DanVrazel/simple-nanoamperemeter/PCB/PCB.kicad_pcb

## KiCad design PCB/PCB.kicad_pcb (2025-10-04)

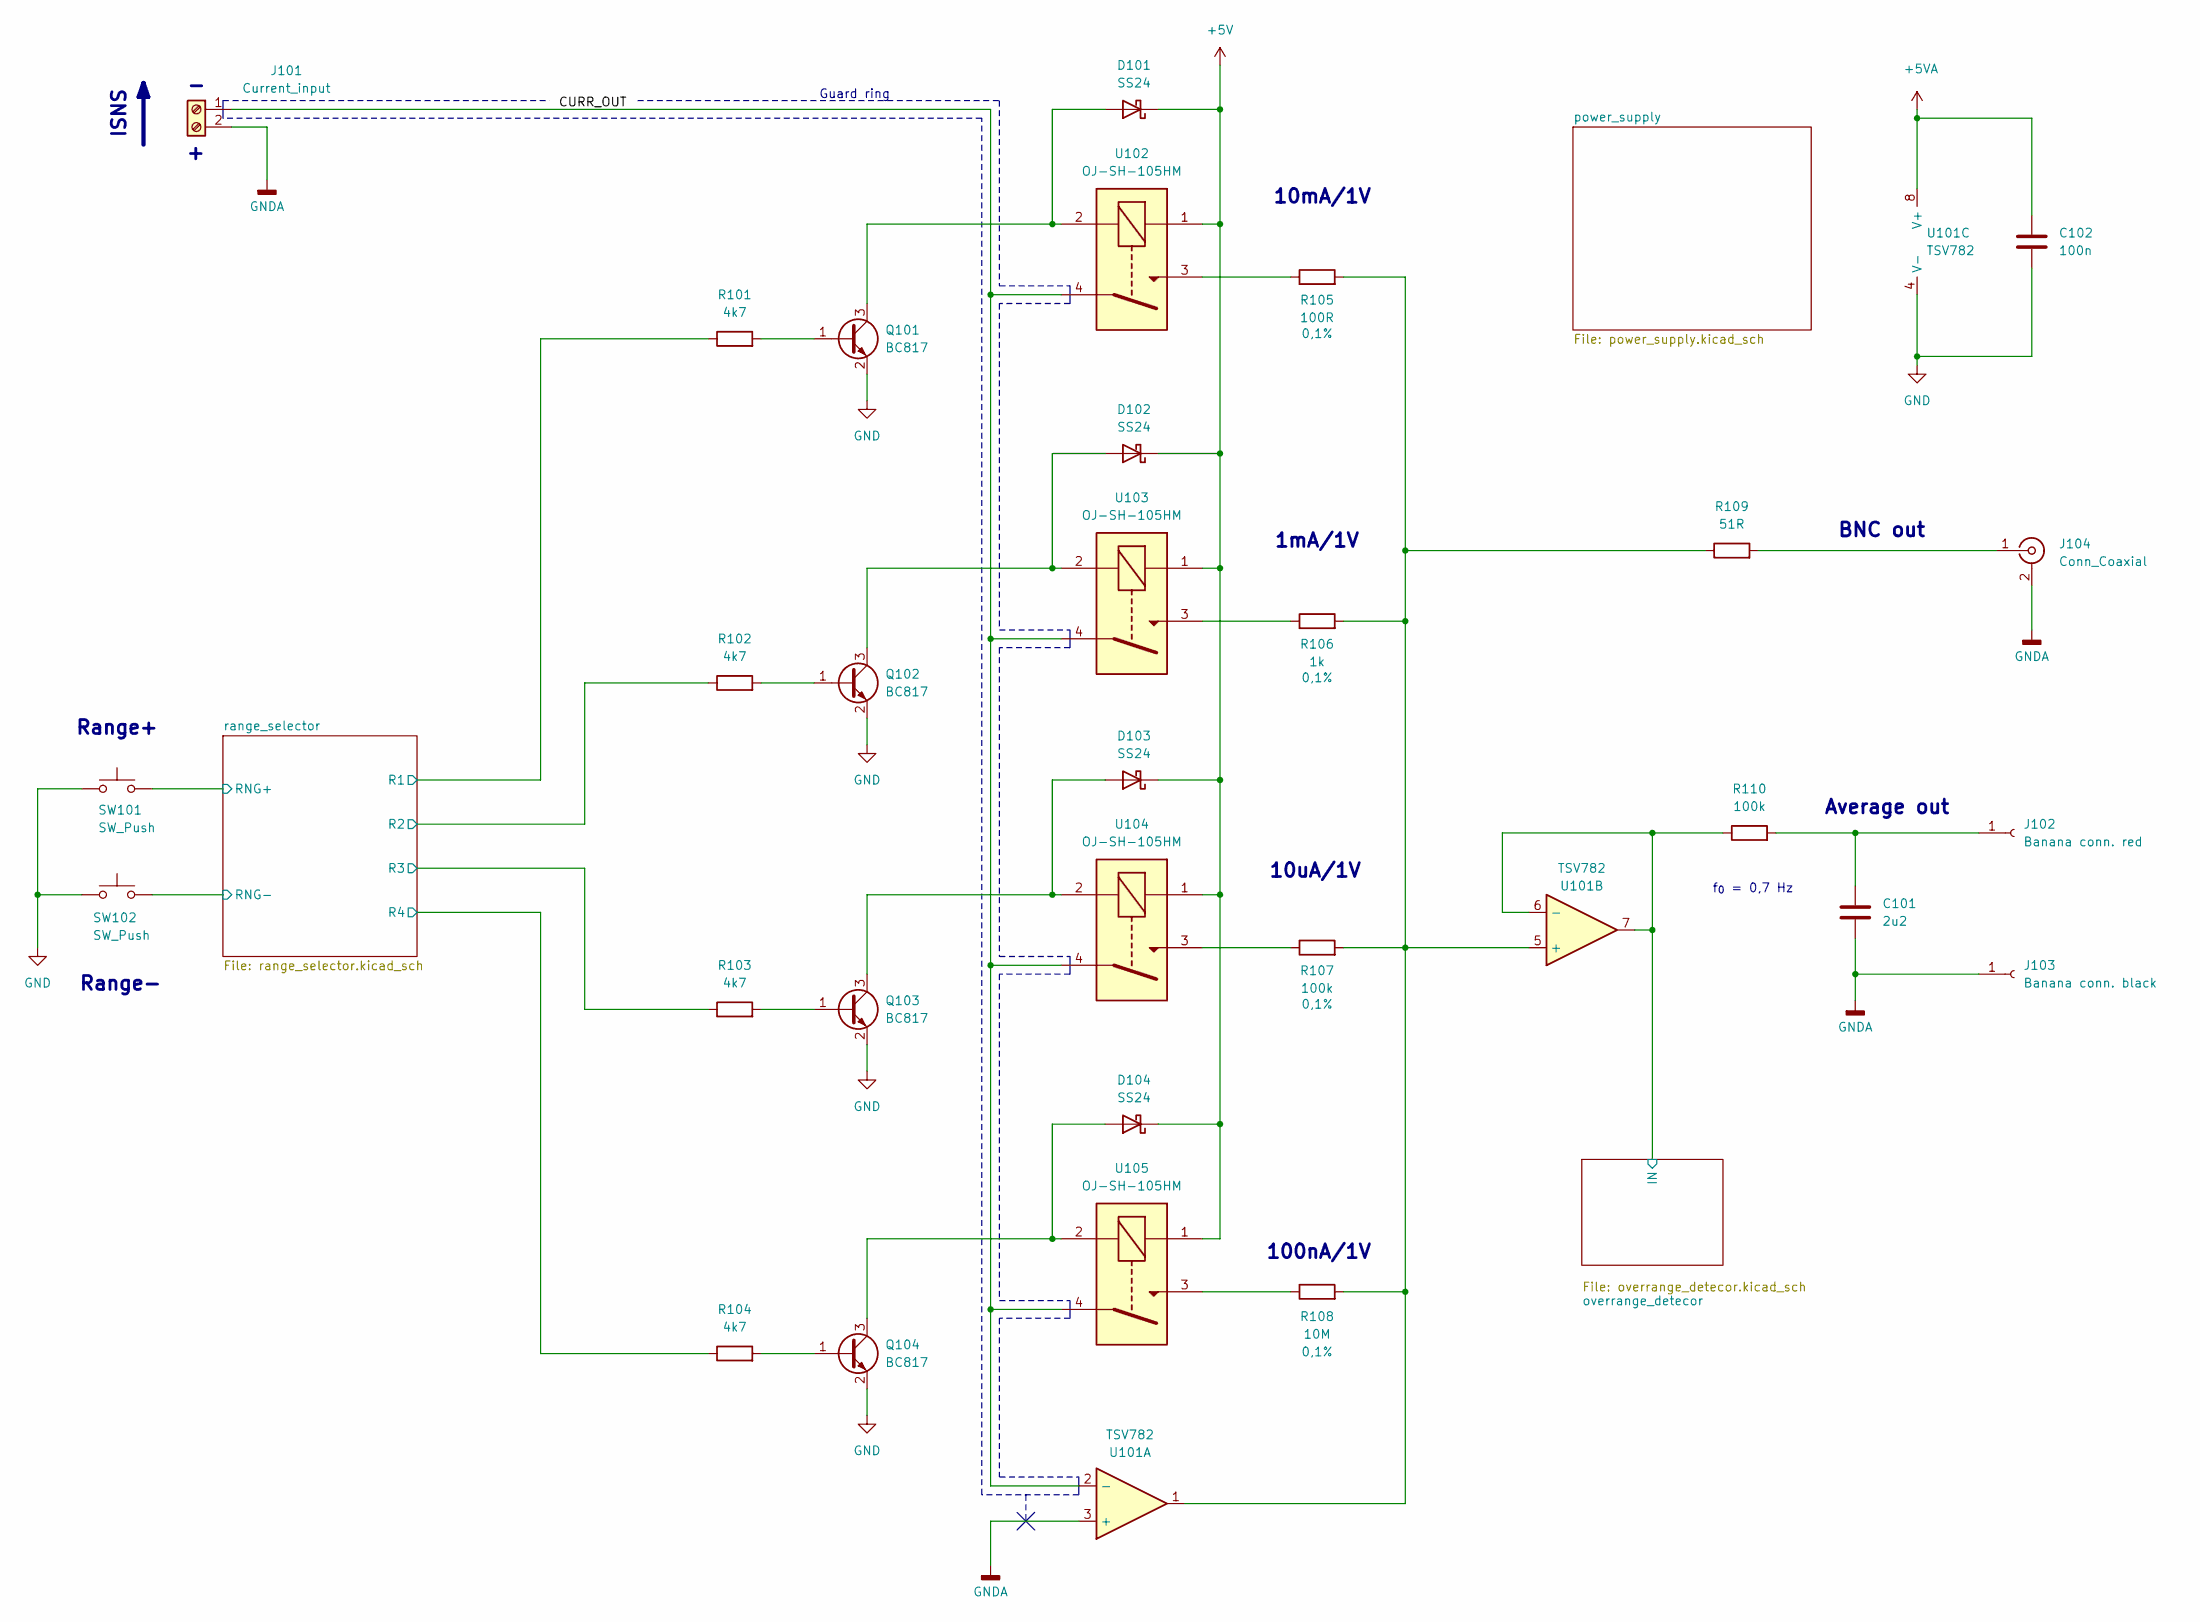
[picture p1: schematic PCB.kicad_sch]

Parts:
C101: 2u2; C_0603_1608Metric
C102: 100n; C_0603_1608Metric
D101, D102, D103, D104: SS24; SOD-123LF
J101: Current_input; Terminal Block 2x3,5mm
J102: Banana conn. red; J.40024.2
J103: Banana conn. black; J.40024.2
J104: Conn_Coaxial; BNC_Amphenol_B6252HB-NPP3G-50_Horizontal
Q101, Q102, Q103, Q104: BC817; SOT-23
R101, R102, R103, R104: 4k7; R_0603_1608Metric
R105: 100R; R_0603_1608Metric
R106: 1k; R_0603_1608Metric
R107, R110: 100k; R_0603_1608Metric
R108: 10M; R_1206_3216Metric; Mouser MCA1206MD1005BP500
R109: 51R; R_0603_1608Metric
SW101, SW102: SW_Push; SW_Tactile_SPST_Angled_PTS645Vx83-2LFS
U101: TSV782; SOIC-8
U102, U103, U104, U105: OJ-SH-105HM; TE Connectivity Relay

Connections:
+5V: D101.1 (K), D102.1 (K), D103.1 (K), D104.1 (K), U102.1, U103.1, U104.1, U105.1; also elsewhere on the board
/CURR_OUT: J101.1, U101.2 (-), U102.4, U103.4, U104.4, U105.4
/overrange_detecor/IN: R110.1, U101.6 (-), U101.7; also elsewhere on the board
/range_selector/R1: R101.1; also elsewhere on the board
/range_selector/R2: R102.1; also elsewhere on the board
/range_selector/R3: R103.1; also elsewhere on the board
/range_selector/R4: R104.1; also elsewhere on the board
/range_selector/RNG+: SW101.2; also elsewhere on the board
/range_selector/RNG-: SW102.2; also elsewhere on the board
GNDA: C101.2, J101.2, J103.1, J104.2 (Ext), U101.3 (+); also elsewhere on the board
unnamed: D101.2 (A), Q101.3 (C), U102.2
unnamed: D102.2 (A), Q102.3 (C), U103.2
unnamed: D103.2 (A), Q103.3 (C), U104.2
unnamed: D104.2 (A), Q104.3 (C), U105.2
unnamed: C101.1, J102.1, R110.2
unnamed: J104.1 (In), R109.2
unnamed: Q101.1 (B), R101.2
unnamed: Q102.1 (B), R102.2
unnamed: Q103.1 (B), R103.2
unnamed: Q104.1 (B), R104.2
unnamed: R105.1, U102.3
unnamed: R106.1, U103.3
unnamed: R107.1, U104.3
unnamed: R108.1, U105.3
unnamed: R105.2, R106.2, R107.2, R108.2, R109.1, U101.1, U101.5 (+)

Notes on the sheet:
10mA/1V
ISNS
Range+
Guard ring
10uA/1V
Average out
100nA/1V
1mA/1V
f_{0} = 0,7 Hz
Range-
BNC out

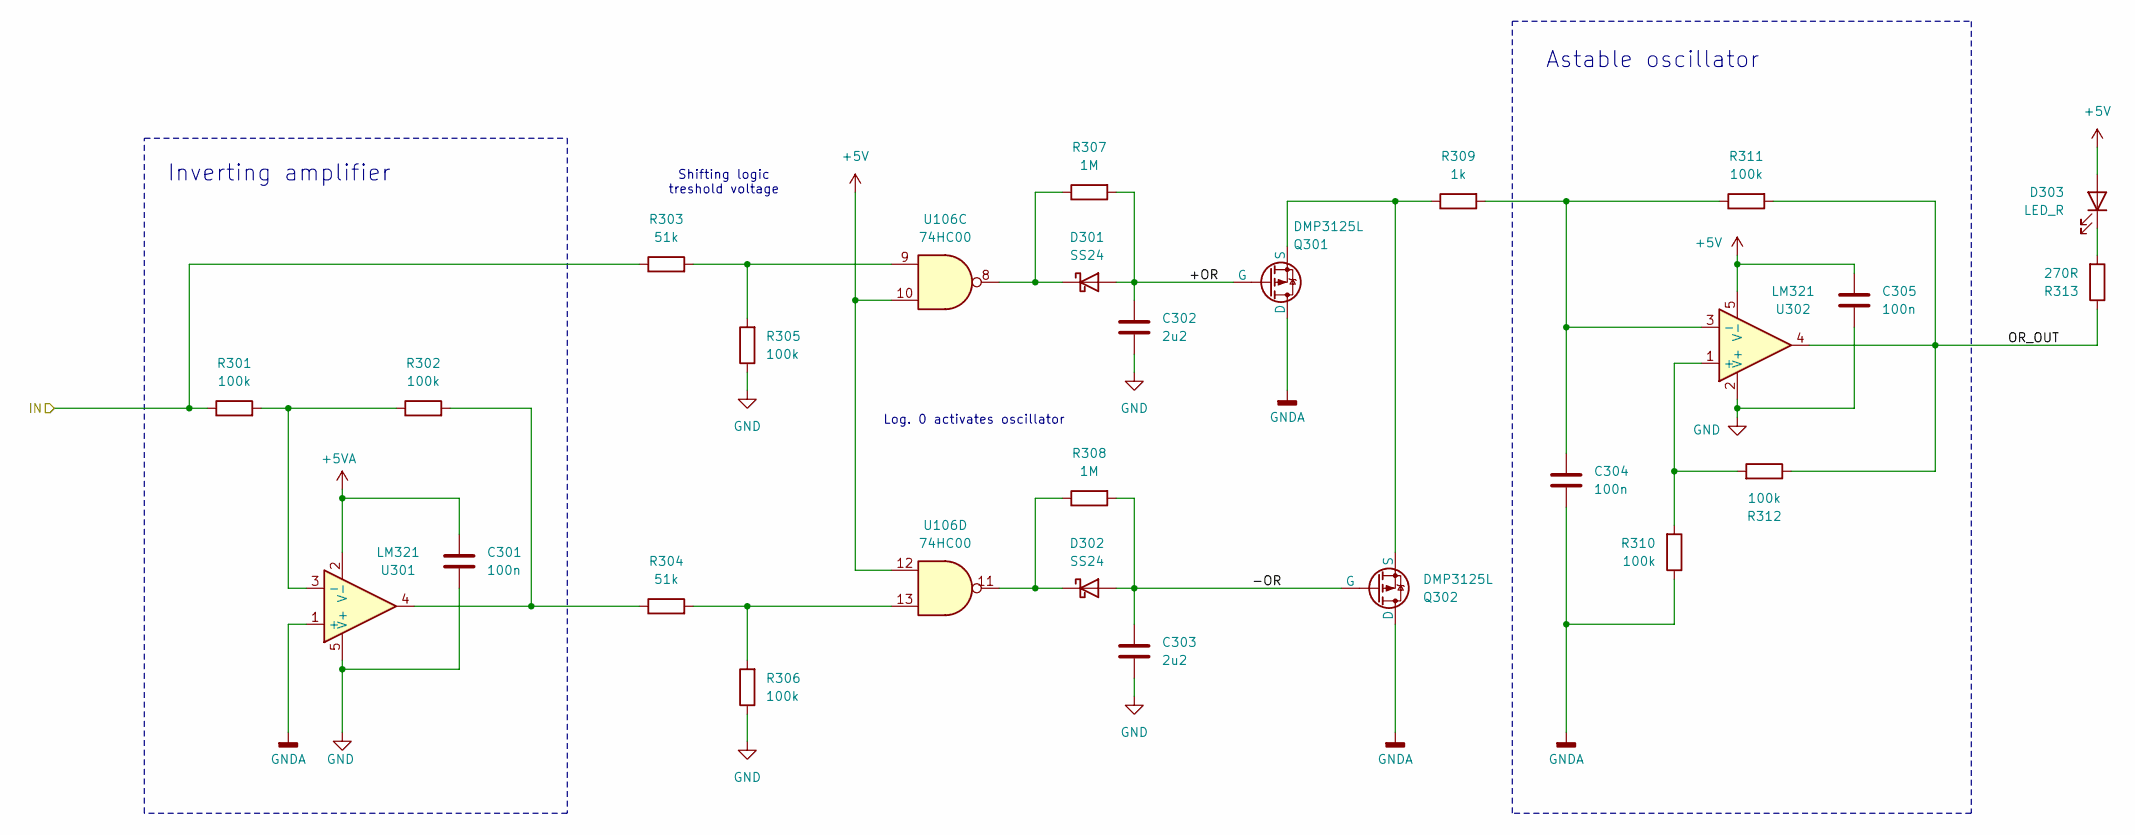
[picture p2: schematic overrange_detecor.kicad_sch]

Parts:
C301, C304, C305: 100n; C_0603_1608Metric
C302, C303: 2u2; C_0603_1608Metric
D301, D302: SS24; SOD-123LF
D303: LED_R; LED_D3.0mm
Q301, Q302: DMP3125L; SOT23-3
R301, R302, R305, R306, R310, R311, R312: 100k; R_0603_1608Metric
R303, R304: 51k; R_0603_1608Metric
R307, R308: 1M; R_0603_1608Metric
R309: 1k; R_0603_1608Metric
R313: 270R; R_0603_1608Metric
U106: 74HC00; SOIC-14 3.9x8.6mm P1.27mm
U301, U302: LM321; SOT-23-5L

Connections:
+5V: C305.1, D303.2 (A), U106.10, U106.12, U302.5 (V-); also elsewhere on the board
/overrange_detecor/+OR: C302.1, D301.2 (A), Q301.1 (G), R307.2
/overrange_detecor/-OR: C303.1, D302.2 (A), Q302.1 (G), R308.2
/overrange_detecor/IN: R301.1, R303.1; also elsewhere on the board
/overrange_detecor/OR_OUT: R311.2, R312.1, R313.1, U302.4
GNDA: C304.2, Q301.2 (D), Q302.2 (D), R310.1, U301.1 (+); also elsewhere on the board
unnamed: D301.1 (K), R307.1, U106.8
unnamed: D302.1 (K), R308.1, U106.11
unnamed: D303.1 (K), R313.2
unnamed: Q301.3 (S), Q302.3 (S), R309.1
unnamed: R302.2, R304.1, U301.4
unnamed: R303.2, R305.2, U106.9
unnamed: R304.2, R306.2, U106.13
unnamed: R301.2, R302.1, U301.3 (-)
unnamed: R310.2, R312.2, U302.1 (+)
unnamed: C304.1, R309.2, R311.1, U302.3 (-)

Notes on the sheet:
Astable oscillator
Log. 0 activates oscillator
Inverting amplifier
Shifting logic treshold voltage

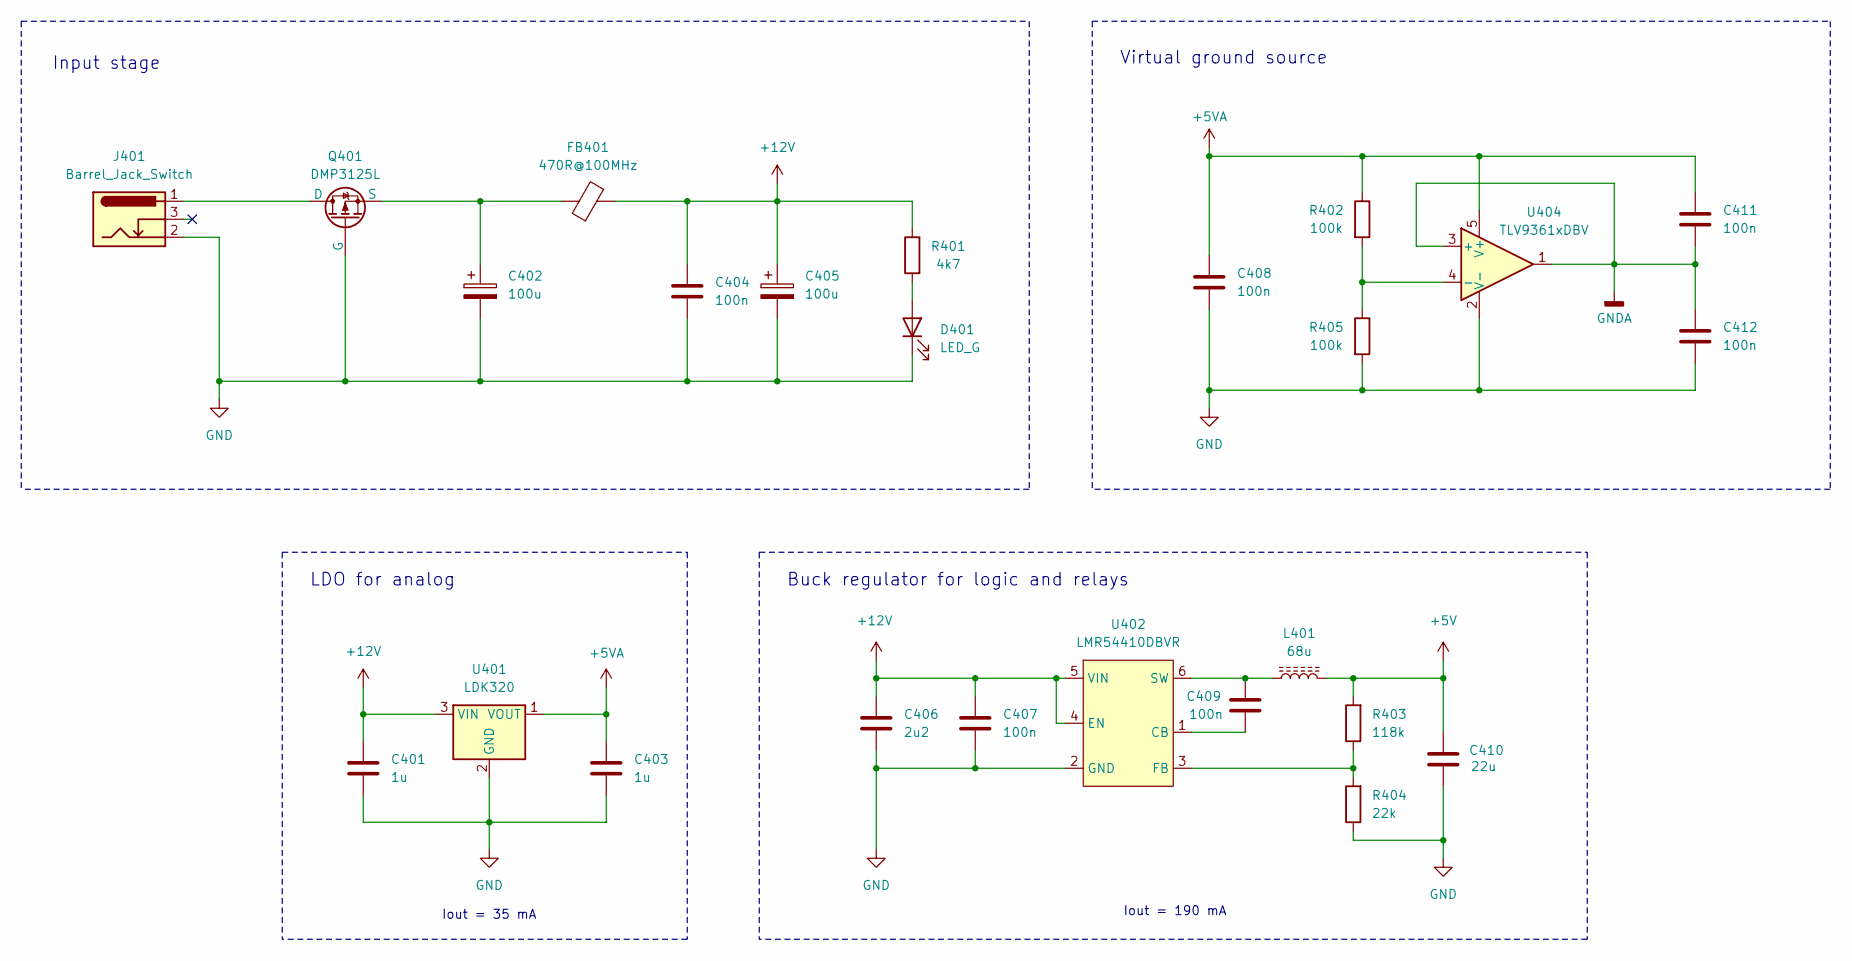
[picture p3: schematic power_supply.kicad_sch]

Parts:
C401, C403: 1u; C_0603_1608Metric
C402, C405: 100u; C_Radial_D6.3mm_H11.0mm_P2.50mm
C404, C407, C408, C409, C411, C412: 100n; C_0603_1608Metric
C406: 2u2; C_0603_1608Metric
C410: 22u; C_0805_2012Metric
D401: LED_G; LED_D3.0mm_Clear
FB401: 470R@100MHz; L_0603_1608Metric
J401: Barrel_Jack_Switch; Barrel jack 6,4mm
L401: 68u; Shielded L 6x6x4.2mm
Q401: DMP3125L; SOT23-3
R401: 4k7; R_0603_1608Metric
R402, R405: 100k; R_0603_1608Metric
R403: 118k; R_0603_1608Metric
R404: 22k; R_0603_1608Metric
U401: LDK320; SOT-89-3
U402: LMR54410DBVR; SOP-6
U404: TLV9361xDBV; SOT-23-5L

Connections:
+5V: C410.2, L401.2, R403.2; also elsewhere on the board
+12V: C401.1, C404.1, C405.1, C406.1, C407.1, FB401.2, R401.1, U401.3 (VIN), U402.4 (EN), U402.5 (VIN)
GNDA: C411.2, C412.1, U404.1, U404.3 (+); also elsewhere on the board
unnamed: D401.2 (A), R401.2
unnamed: J401.1, Q401.2 (D)
unnamed: C402.1, FB401.1, Q401.3 (S)
unnamed: C409.1, U402.1 (CB)
unnamed: R403.1, R404.2, U402.3 (FB)
unnamed: C409.2, L401.1, U402.6 (SW)
unnamed: R402.2, R405.1, U404.4 (-)

Notes on the sheet:
Iout = 190 mA
Buck regulator for logic and relays
LDO for analog
Iout = 35 mA
Virtual ground source
Input stage

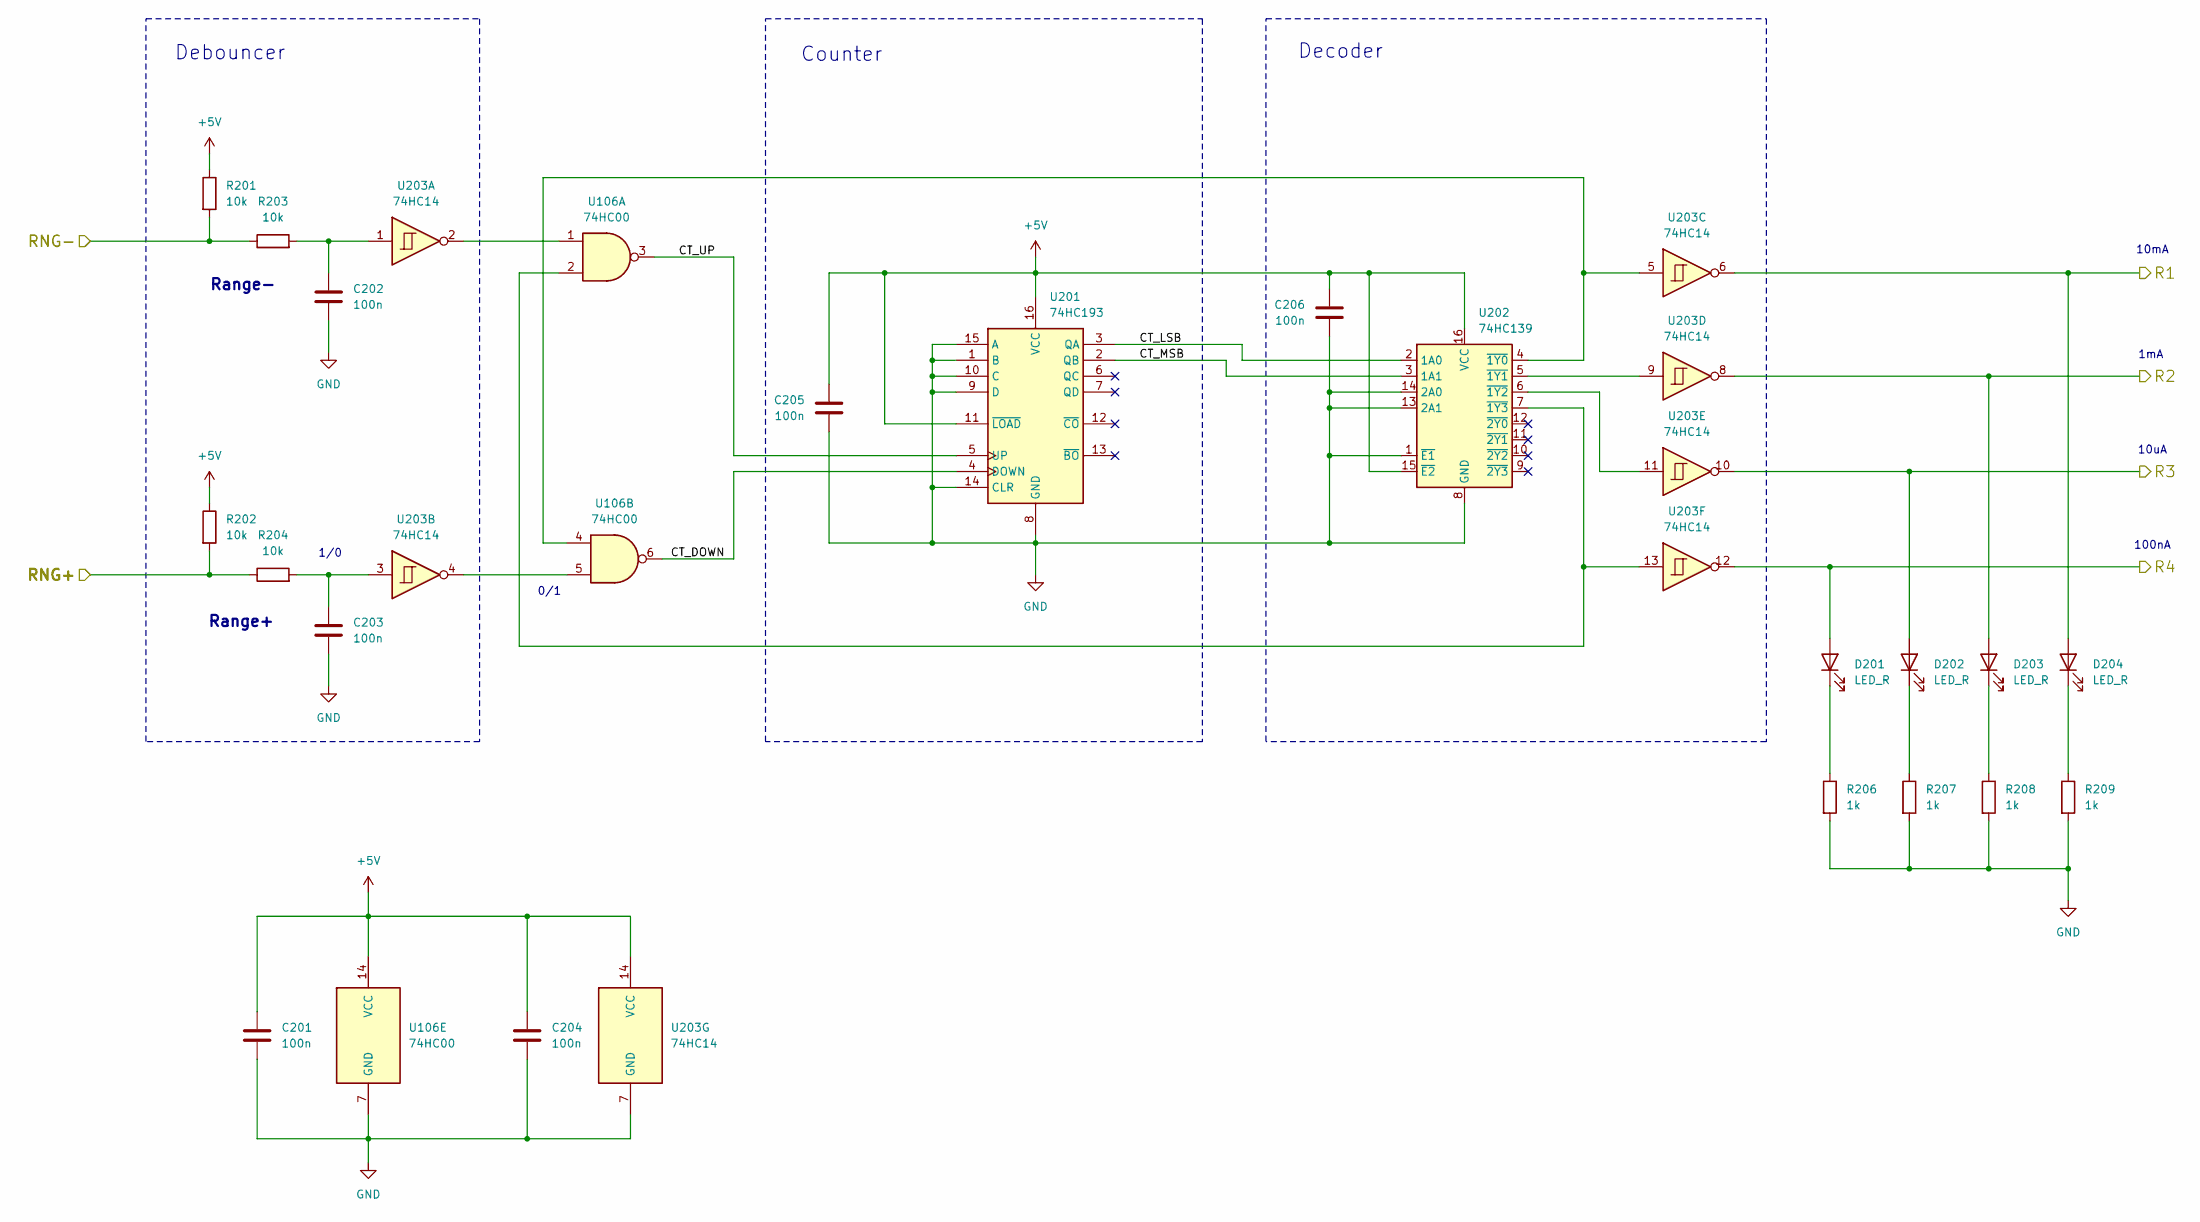
[picture p4: schematic range_selector.kicad_sch]

Parts:
C201, C202, C203, C204, C205, C206: 100n; C_0603_1608Metric
D201, D202, D203, D204: LED_R; LED_D3.0mm
R201, R202, R203, R204: 10k; R_0603_1608Metric
R206, R207, R208, R209: 1k; R_0603_1608Metric
U106: 74HC00; SOIC-14 3.9x8.6mm P1.27mm
U201: 74HC193; SOIC-16 3.9x9.9mm P1.27mm
U202: 74HC139; SOIC-16 3.9x9.9mm P1.27mm
U203: 74HC14; SOIC-14 3.9x8.6mm P1.27mm

Connections:
+5V: C201.1, C204.1, C205.1, C206.1, R201.1, R202.1, U106.14 (VCC), U201.11 (~LOAD), U201.16 (VCC), U202.15 (~E2), U202.16 (VCC), U203.14 (VCC); also elsewhere on the board
/range_selector/CT_DOWN: U106.6, U201.4 (DOWN)
/range_selector/CT_LSB: U201.3 (QA), U202.2 (1A0)
/range_selector/CT_MSB: U201.2 (QB), U202.3 (1A1)
/range_selector/CT_UP: U106.3, U201.5 (UP)
/range_selector/R1: D204.2 (A), U203.6; also elsewhere on the board
/range_selector/R2: D203.2 (A), U203.8; also elsewhere on the board
/range_selector/R3: D202.2 (A), U203.10; also elsewhere on the board
/range_selector/R4: D201.2 (A), U203.12; also elsewhere on the board
/range_selector/RNG+: R202.2, R204.1; also elsewhere on the board
/range_selector/RNG-: R201.2, R203.1; also elsewhere on the board
unnamed: C202.1, R203.2, U203.1
unnamed: C203.1, R204.2, U203.3
unnamed: D201.1 (K), R206.1
unnamed: D202.1 (K), R207.1
unnamed: D203.1 (K), R208.1
unnamed: D204.1 (K), R209.1
unnamed: U106.1, U203.2
unnamed: U106.5, U203.4
unnamed: U106.4, U202.4 (~1Y0), U203.5
unnamed: U202.5 (~1Y1), U203.9
unnamed: U202.6 (~1Y2), U203.11
unnamed: U106.2, U202.7 (~1Y3), U203.13

Notes on the sheet:
Decoder
Counter
1/0
Range-
10mA
Range+
0/1
1mA
10uA
Debouncer
100nA

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
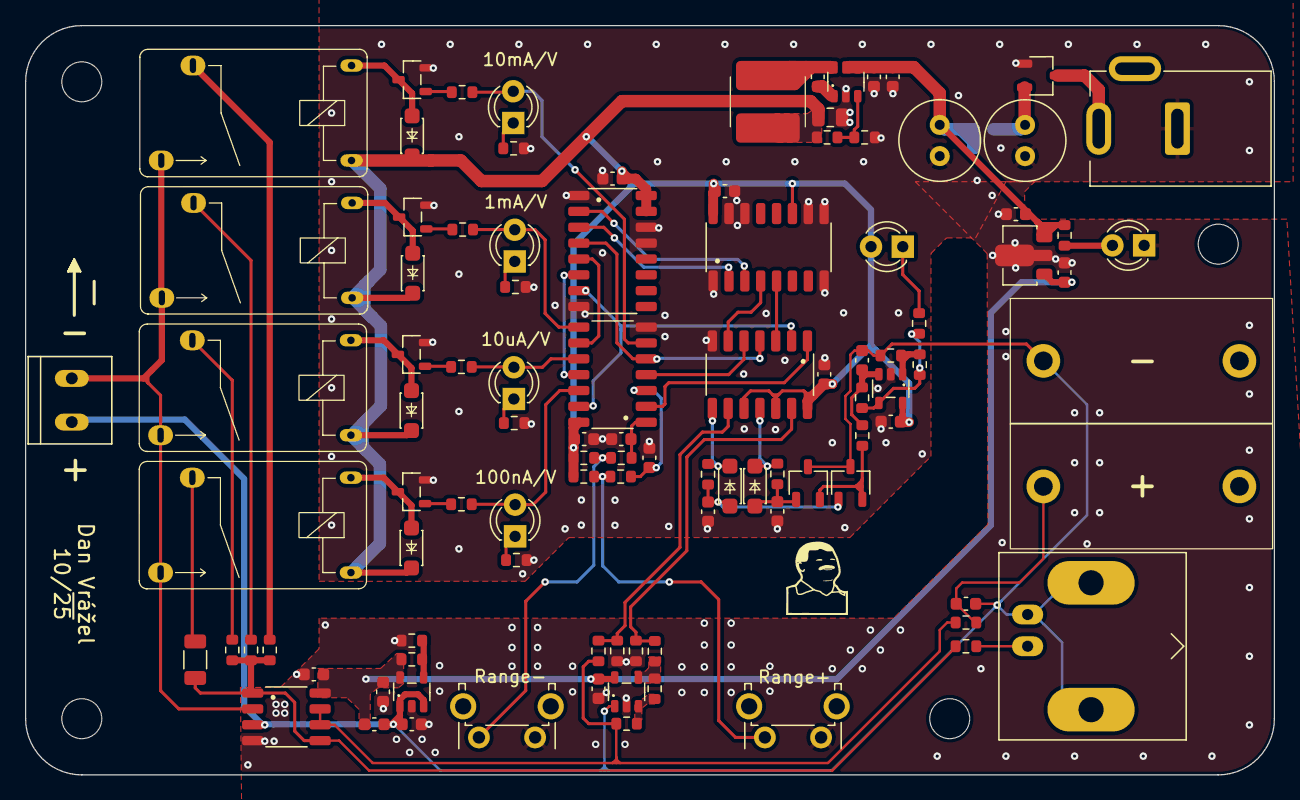
[picture p5: board PCB.kicad_pcb from above]

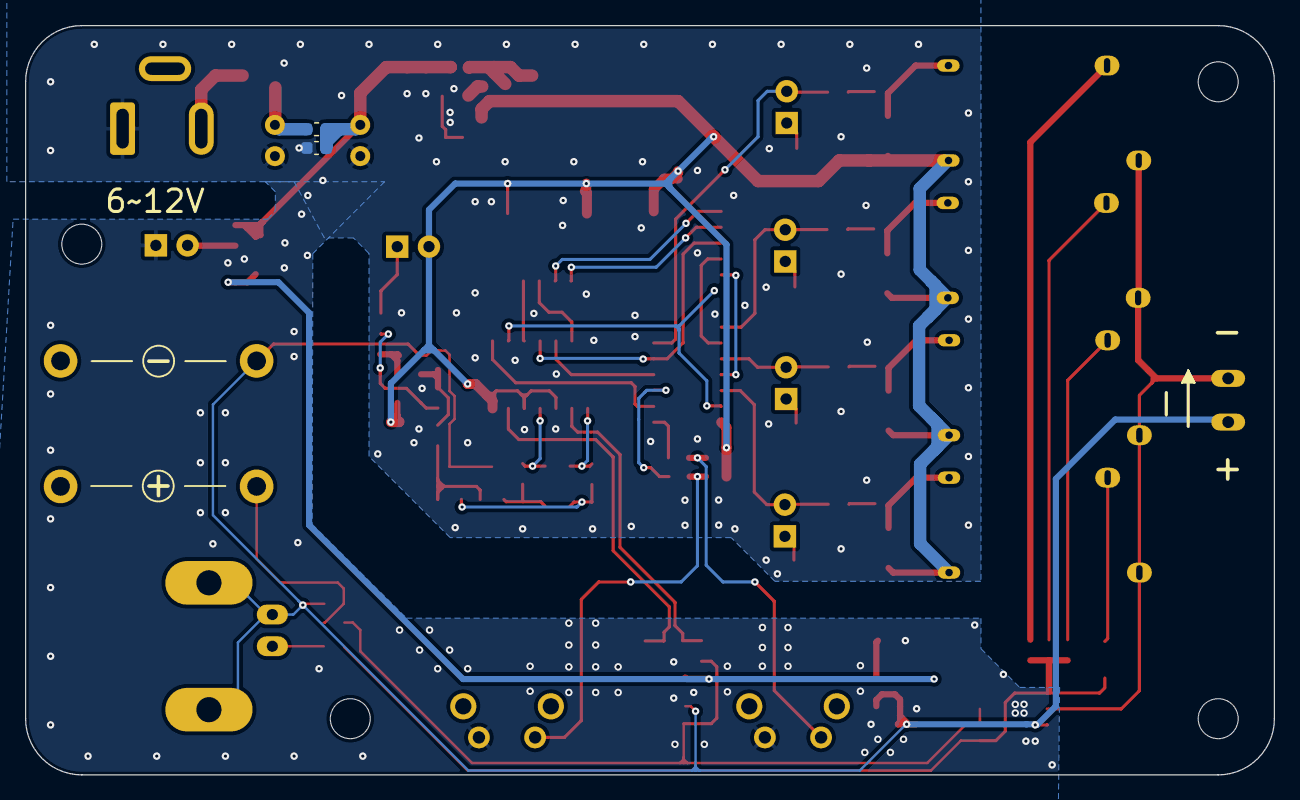
[picture p6: board PCB.kicad_pcb from below]

Board: 2 copper layers, 100.0 x 60.0 mm, 103 parts (2 on the bottom side), 64 nets.
