DanVrazel/simple-nanoamperemeter/(commit log)

2025-09-02 power supply
    [PCB.kicad_pcb, PCB.kicad_sch]
2025-09-03 schematic progress
    [PCB.kicad_sch]
2025-09-04 range switching
    [PCB.kicad_sch, range_selector.kicad_sch]
2025-09-04 astable op amp
    [PCB.kicad_sch]
2025-09-07 schematic roughly done
    [PCB.kicad_sch, overrange_detecor.kicad_sch, power_supply.kicad_sch, range_selector.kicad_sch]
2025-09-09 footprints and overrange detector timing
    [PCB.kicad_sch, overrange_detecor.kicad_sch, power_supply.kicad_sch]
2025-09-12 start of layout
    [PCB.kicad_pcb, PCB.kicad_sch, overrange_detecor.kicad_sch, power_supply.kicad_sch, range_selector.kicad_sch]
2025-09-14 rough layout done
    [PCB.kicad_pcb, PCB.kicad_sch, overrange_detecor.kicad_sch]
2025-09-15 almost done
    [PCB.kicad_pcb, overrange_detecor.kicad_sch]
2025-09-16 rev 1 done
    [PCB-B_Cu.gbr, PCB-B_Mask.gbr, PCB-B_Paste.gbr, PCB-B_Silkscreen.gbr, PCB-Edge_Cuts.gbr, PCB-F_Cu.gbr, PCB-F_Mask.gbr, PCB-F_Paste.gbr]
2025-10-04 changed BNC footprint
    [PCB-B_Cu.gbr, PCB-B_Mask.gbr, PCB-B_Paste.gbr, PCB-B_Silkscreen.gbr, PCB-Edge_Cuts.gbr, PCB-F_Cu.gbr, PCB-F_Mask.gbr, PCB-F_Paste.gbr]
